martin-mael/sub-eq/viewer/screenshots/07_rayons_x.png

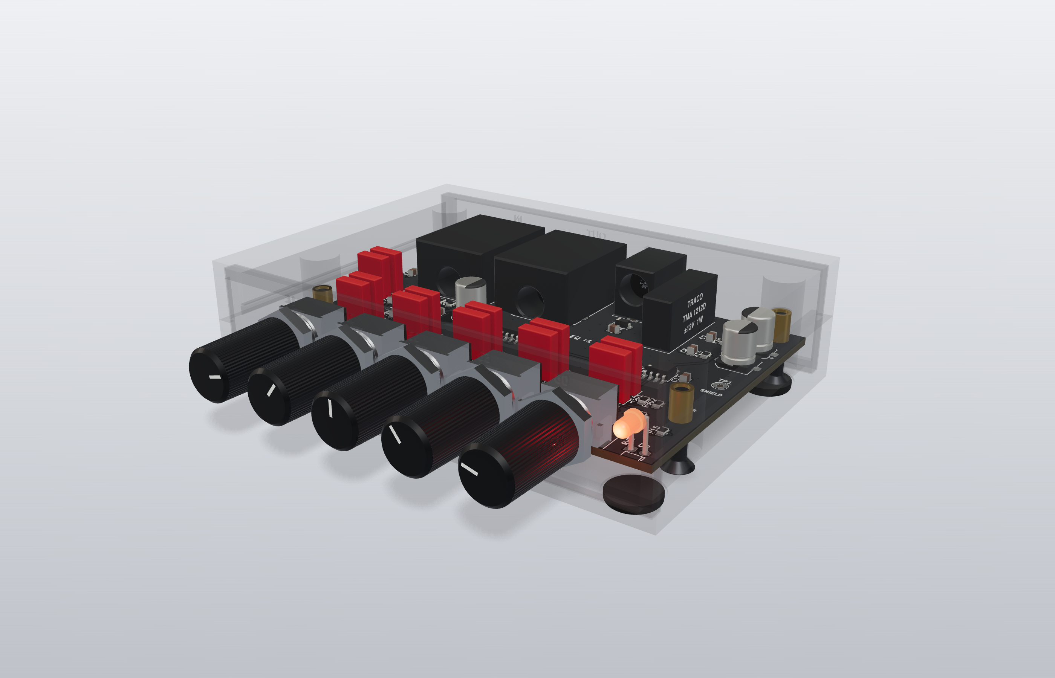
viewer/screenshots/07_rayons_x.png
