martin-mael/sub-eq/viewer/screenshots/01_avant_3-4.png

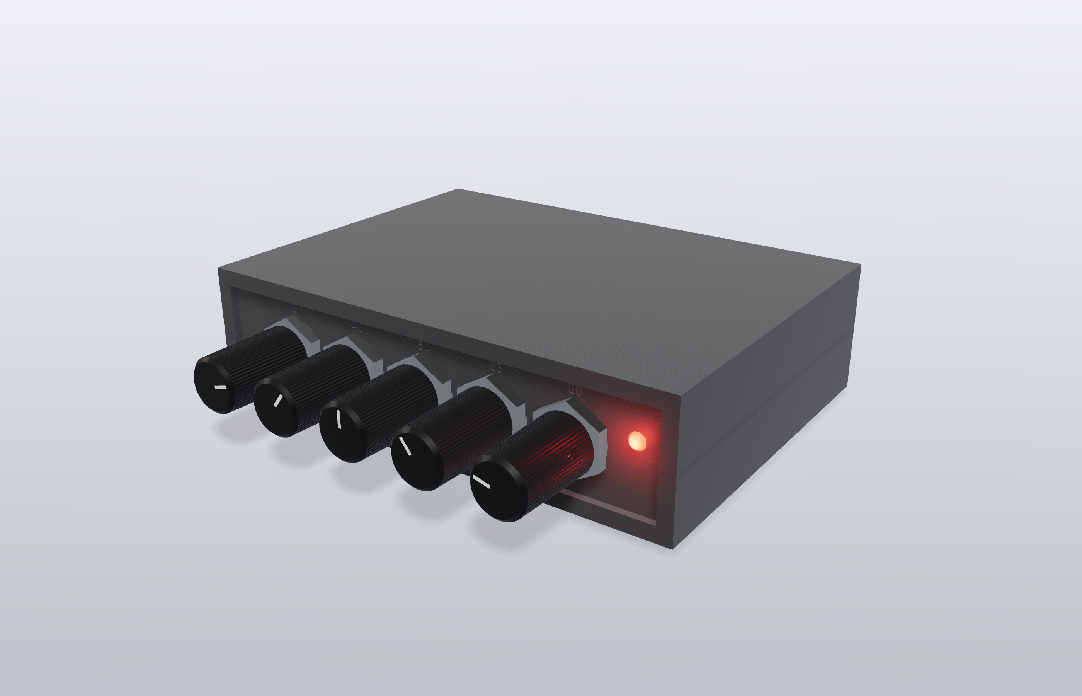
viewer/screenshots/01_avant_3-4.png
