martin-mael/sub-eq/README.md

# Sub EQ

Égaliseur graphique 5 bandes pour caissons de basses (31, 40, 50, 63, 80 Hz), mono, jacks 6,35 mm, alimentation 12 V DC. Exemplaire unique, PCB 90 × 62 mm, boîtier 97 × 71 × 25 mm.

| Document | Contenu |
|---|---|
| [docs/SPEC.md](docs/SPEC.md) | spécification validée et valeurs figées à la conception |
| [docs/sub-eq-fiche.pdf](docs/sub-eq-fiche.pdf) | fiche de présentation : schéma fonctionnel, courbes, carte, nomenclature, coût |
| [docs/BOM.md](docs/BOM.md) | nomenclature détaillée de tous les composants |
| [docs/COMMANDE.md](docs/COMMANDE.md) | PCB, composants, visserie à commander |
| [docs/CHIFFRAGE.md](docs/CHIFFRAGE.md) | coût détaillé |
| [docs/MONTAGE.md](docs/MONTAGE.md) | contrôles, impression, soudure, tests, assemblage |
| [docs/ASSEMBLAGE-JLC.md](docs/ASSEMBLAGE-JLC.md) | option : CMS posés par JLCPCB, devis pour 2, 5 et 10 cartes |

## Fichiers produits

- `hardware/sub-eq.kicad_sch`, `hardware/sub-eq.kicad_pcb` : schéma et carte (générés, ne pas éditer à la main).
- `hardware/fab/` : Gerbers zippés, nomenclatures, PDF du schéma et de l'implantation, STEP de la carte.
- `hardware/sim-report.txt` : réponse calculée à partir des valeurs réelles du circuit.
- `enclosure/out/` : STL et STEP des 4 pièces imprimées, vue éclatée `preview.png`.
- `viewer/` : visionneuse 3D web (voir [viewer/README.md](viewer/README.md)).

| Domaine | Source | Généré |
|---|---|---|
| Visionneuse | `viewer/src/scene/dims.ts`, `Connectors.tsx` | `viewer/public/models/` via `npm run assets` |

Toute modification d'une pièce de panneau se répercute dans `hardware/scripts/gen_pcb.py`, `enclosure/enclosure.py` et `viewer/src/scene/dims.ts`.

## Régénérer

La fiche PDF et `docs/BOM.md` se régénèrent à part, après `build.sh` : `cd hardware/scripts && ../../.venv/bin/python build_doc.py` (il faut Google Chrome et `pypdf`).

```bash
FREEROUTING_JAR=~/.cache/freerouting/freerouting-2.5.0.jar ./build.sh
```

Il faut KiCad 10 dans `~/Applications/KiCad`, Java 21 ou plus, [Freerouting](https://github.com/freerouting/freerouting/releases) 2.5 et un `.venv` avec `numpy`, `build123d` et `cairosvg` (ici un lien vers celui d'audio-box).

Visionneuse 3D : `cd viewer && npm install && npm run assets && npm run dev` (http://localhost:5174).

## Déploiement de la visionneuse sur Vercel

Dans le projet Vercel, le **Root Directory** est `viewer` : Vercel y détecte Vite et lance `npm install`, `npm run build`, puis publie `dist`. `viewer/vercel.json` ne fait que fixer le framework. Les modèles 3D (`viewer/public/models/`) sont versionnés : Vercel n'a besoin ni de KiCad ni de Python. Relance `npm run assets` et commite avant de pousser si le PCB ou le boîtier a changé.
