martin-mael/sub-eq/hardware/sim-report.txt

all pots centred: +0.0000 dB at 50 Hz, +0.0000 dB at 1 kHz

filter cells (design: f0 = 1/(2 pi C sqrt(R3 (R1||R2))), Q = pi f0 C R3, gain = R3/(2 R1)):
  31 Hz: f0 31.5 Hz  Q 4.36  gain 1.000
  40 Hz: f0 40.1 Hz  Q 4.22  gain 1.000
  50 Hz: f0 50.2 Hz  Q 4.30  gain 1.000
  63 Hz: f0 62.9 Hz  Q 4.35  gain 1.000
  80 Hz: f0 80.3 Hz  Q 4.33  gain 1.000

one band at a time (peak frequency, gain, -3 dB Q):
  31 Hz: full boost  31.1 Hz +12.37 dB (Q 2.9) | full cut  31.1 Hz -12.37 dB | pot at 75 %: +3.6 dB
  40 Hz: full boost  39.8 Hz +12.59 dB (Q 3.9) | full cut  39.8 Hz -12.59 dB | pot at 75 %: +3.8 dB
  50 Hz: full boost  50.3 Hz +12.60 dB (Q 4.1) | full cut  50.3 Hz -12.60 dB | pot at 75 %: +3.8 dB
  63 Hz: full boost  63.4 Hz +12.57 dB (Q 3.9) | full cut  63.4 Hz -12.57 dB | pot at 75 %: +3.8 dB
  80 Hz: full boost  81.4 Hz +12.44 dB (Q 2.5) | full cut  81.4 Hz -12.44 dB | pot at 75 %: +3.7 dB

   f     all max  all min  31 max   80 max   +-+-+    with HPF, flat   largest internal node (V per V in, all max)
  10.0   +8.67    -8.67    +3.04    +0.97    +2.13   -12.35           0.96
  16.0  +12.61   -12.61    +5.72    +1.79    +2.98    -5.40           0.89
  20.0  +14.62   -14.62    +7.48    +2.13    +3.52    -3.04           0.81
  25.0  +16.58   -16.58    +9.83    +2.15    +4.52    -1.51           0.65
  31.5  +17.04   -17.04   +12.34    +1.35    +4.94    -0.66           0.43
  35.0  +16.24   -16.24    +9.21    +1.61    -1.19    -0.45           0.48
  40.0  +16.73   -16.73    +4.24    +1.47    -5.66    -0.27           0.42
  45.0  +16.11   -16.11    +3.04    +1.95    +1.07    -0.17           0.46
  50.0  +16.66   -16.66    +1.99    +1.98    +6.06    -0.11           0.42
  56.0  +16.10   -16.10    +1.98    +3.00    +1.20    -0.07           0.46
  63.0  +16.74   -16.74    +1.48    +4.14    -5.71    -0.04           0.42
  71.0  +16.22   -16.22    +1.71    +8.37    -2.30    -0.03           0.48
  80.0  +16.95   -16.95    +1.34   +12.39    +4.97    -0.02           0.44
  90.0  +17.27   -17.27    +1.82   +11.50    +5.57    -0.01           0.52
 100.0  +16.66   -16.66    +2.12   +10.06    +4.75    -0.01           0.64
 125.0  +14.71   -14.71    +2.13    +7.65    +3.67    -0.00           0.80
 160.0  +12.48   -12.48    +1.76    +5.69    +3.05    -0.00           0.89
 250.0   +8.74    -8.74    +0.98    +3.13    +2.22    -0.00           0.96
1000.0   +1.43    -1.43    +0.08    +0.27    +0.34    -0.00           1.00

subsonic HPF: f0 = 20.06 Hz, Q = 0.707
