martin-mael/sub-eq/docs/img/pcb.png

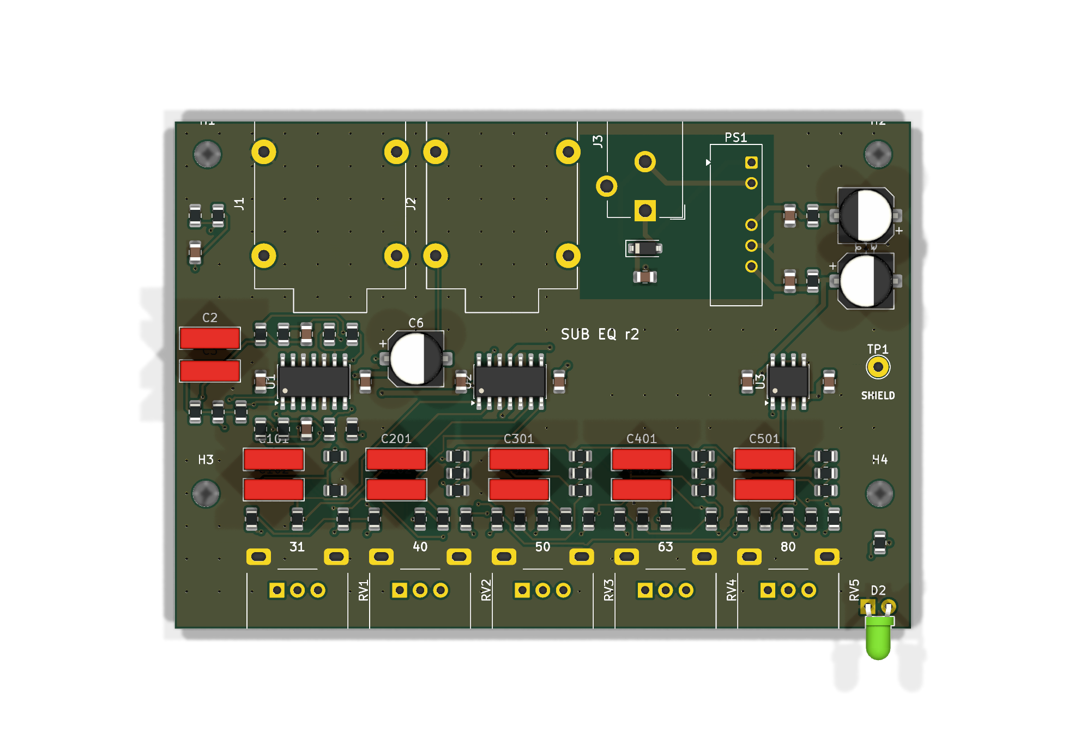
docs/img/pcb.png
