martin-mael/sub-eq/viewer/screenshots/02_arriere_3-4.png

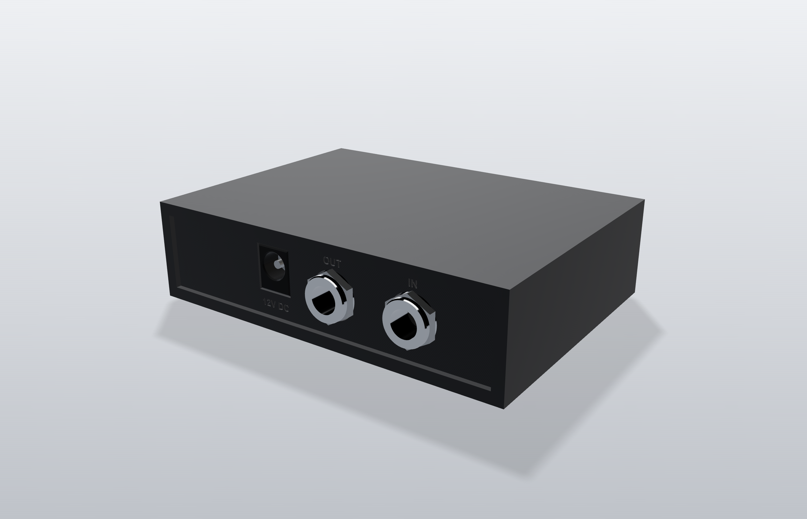
viewer/screenshots/02_arriere_3-4.png
