martin-mael/sub-eq/viewer/screenshots/03_eclate_avant.png

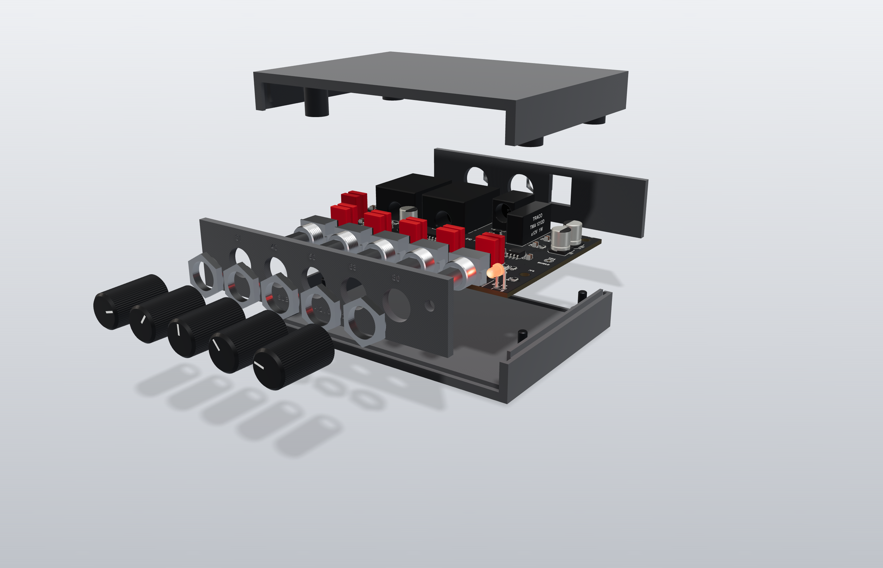
viewer/screenshots/03_eclate_avant.png
