martin-mael/sub-eq/viewer/screenshots/04_eclate_arriere.png

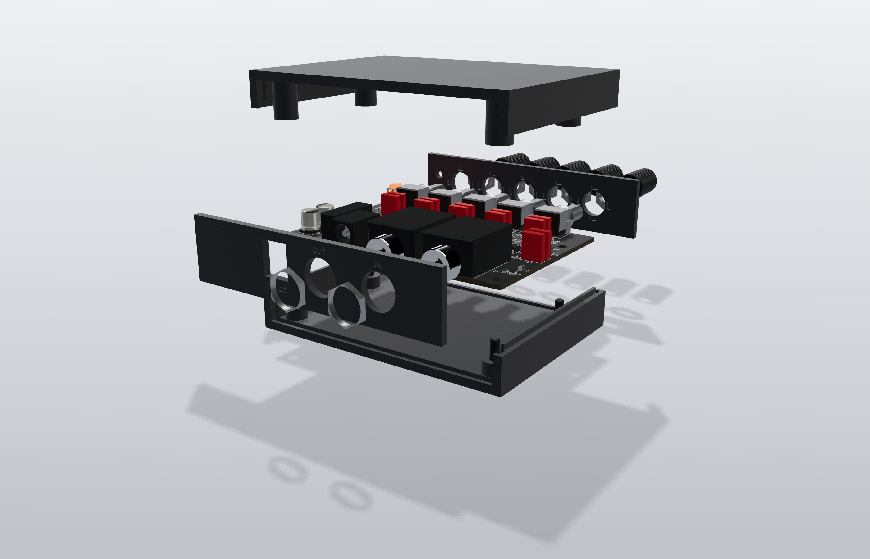
viewer/screenshots/04_eclate_arriere.png
