martin-mael/sub-eq/viewer/screenshots/05_gros_plan_avant.png

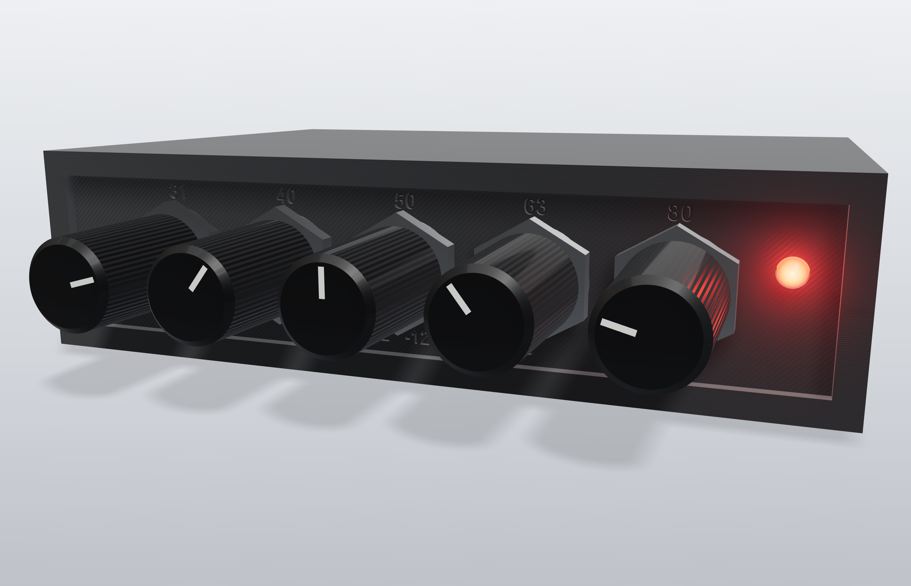
viewer/screenshots/05_gros_plan_avant.png
