martin-mael/sub-eq/hardware/fab/bom_mouser_smd.csv

Manufacturer | Manufacturer Part Number | Quantity | Designators | Qty on board | Description
Yageo | CC0805JRNPO9BN102 | 10 | C1 | 1 | Cap 1nF 50V 0805 (C0G here; X7R is fine too)
Nichicon | UWT1V101MCL1GS | 4 | C10 C11 C6 | 3 | Alu electrolytic 100uF 35V 6.3x7.7
Yageo | CC0805KRX7R9BB104 | 20 | C12 C13 C14 C15 C16 C17 | 6 | Cap 100nF 50V X7R 0805
Samsung | CL21C220JBANNNC | 10 | C4 C5 | 2 | Cap 22pF 50V C0G 0805
Samsung | CL21A106KAYNNNG | 10 | C7 C8 C9 | 3 | Cap 10uF 25V X5R 0805
Diodes Inc. | 1N5819HW-7-F | 2 | D1 | 1 | Schottky 40 V 1 A SOD-123 (reverse-polarity protection)
Yageo | RC0805FR-071ML | 10 | R1 | 1 | Resistor 1M 1% 0805
Yageo | RC0805FR-0720KL | 10 | R10 R5 R6 R7 R8 R9 | 6 | Resistor 20k 1% 0805
Yageo | RC0805FR-07100KL | 10 | R101 R12 R303 R403 | 4 | Resistor 100k 1% 0805
Yageo | RC0805FR-072K7L | 10 | R102 | 1 | Resistor 2.7k 1% 0805
Yageo | RC0805FR-07200KL | 10 | R103 | 1 | Resistor 200k 1% 0805
Yageo | RC0805FR-072KL | 10 | R104 R105 R204 R205 R304 R305 R404 R405 R504 R505 | 10 | Resistor 2k 1% 0805
Yageo | RC0805FR-07100RL | 10 | R11 | 1 | Resistor 100 1% 0805
Yageo | RC0805FR-0710RL | 10 | R13 R14 | 2 | Resistor 10 1% 0805
Yageo | RC0805FR-074K7L | 10 | R15 | 1 | Resistor 4.7k 1% 0805
Yageo | RC0805FR-0751KL | 10 | R16 R3 R4 | 3 | Resistor 51k 1% 0805
Yageo | RC0805FR-07470RL | 10 | R2 | 1 | Resistor 470 1% 0805
Yageo | RC0805FR-0768KL | 10 | R201 R503 | 2 | Resistor 68k 1% 0805
Yageo | RC0805FR-072K2L | 10 | R202 | 1 | Resistor 2.2k 1% 0805
Yageo | RC0805FR-07150KL | 10 | R203 | 1 | Resistor 150k 1% 0805
Yageo | RC0805FR-078K2L | 10 | R206 | 1 | Resistor 8.2k 1% 0805
Yageo | RC0805FR-072K4L | 10 | R208 | 1 | Resistor 2.4k 1% 0805
Yageo | RC0805FR-0747KL | 10 | R301 R401 | 2 | Resistor 47k 1% 0805
Yageo | RC0805FR-071K5L | 10 | R302 | 1 | Resistor 1.5k 1% 0805
Yageo | RC0805FR-0715KL | 10 | R306 | 1 | Resistor 15k 1% 0805
Panasonic | ERJ-6ENF2200V | 10 | R307 | 1 | Resistor 220 1% 0805 (Yageo out of stock)
Yageo | RC0805FR-0724KL | 10 | R308 | 1 | Resistor 24k 1% 0805
Yageo | RC0805FR-07680RL | 10 | R402 R407 R502 | 3 | Resistor 680 1% 0805
Yageo | RC0805FR-073KL | 10 | R406 | 1 | Resistor 3k 1% 0805
Yageo | RC0805FR-0727KL | 10 | R501 | 1 | Resistor 27k 1% 0805
Yageo | RC0805FR-0712KL | 10 | R506 | 1 | Resistor 12k 1% 0805
Yageo | RC0805FR-07390RL | 10 | R507 | 1 | Resistor 390 1% 0805
Yageo | RC0805FR-0710KL | 10 | R508 | 1 | Resistor 10k 1% 0805
Texas Instruments | TL074CDR | 2 | U1 U2 | 2 | Quad JFET op-amp SOIC-14
Texas Instruments | TL072CDR | 1 | U3 | 1 | Dual JFET op-amp SOIC-8
