martin-mael/sub-eq/hardware/jlc/bom_jlc.csv

Comment | Designator | Footprint | JLCPCB Part #
1n | C1 | C_0805_2012Metric | C46653
22p C0G | C4,C5 | C_0805_2012Metric | C1804
100u 35V | C6,C10,C11 | CP_Elec_6.3x7.7 | C970686
10u 25V | C7,C8,C9 | C_0805_2012Metric | C15850
100n | C12,C13,C14,C15,C16,C17 | C_0805_2012Metric | C49678
1N5819HW | D1 | D_SOD-123 | C8598
1M | R1 | R_0805_2012Metric | C17514
470 | R2 | R_0805_2012Metric | C17710
51k | R3,R4,R16 | R_0805_2012Metric | C17737
20k | R5,R6,R7,R8,R9,R10 | R_0805_2012Metric | C4328
100 | R11 | R_0805_2012Metric | C17408
100k | R12,R101,R303,R403 | R_0805_2012Metric | C149504
10 | R13,R14 | R_0805_2012Metric | C17415
4.7k | R15 | R_0805_2012Metric | C17673
2.7k | R102 | R_0805_2012Metric | C17530
200k | R103 | R_0805_2012Metric | C17539
2k | R104,R105,R204,R205,R304,R305,R404,R405,R504,R505 | R_0805_2012Metric | C17604
68k | R201,R503 | R_0805_2012Metric | C17801
2.2k | R202 | R_0805_2012Metric | C17520
150k | R203 | R_0805_2012Metric | C17470
8.2k | R206 | R_0805_2012Metric | C17828
2.4k | R208 | R_0805_2012Metric | C17526
47k | R301,R401 | R_0805_2012Metric | C17713
1.5k | R302 | R_0805_2012Metric | C4310
15k | R306 | R_0805_2012Metric | C17475
220 | R307 | R_0805_2012Metric | C17557
24k | R308 | R_0805_2012Metric | C17575
680 | R402,R407,R502 | R_0805_2012Metric | C17798
3k | R406 | R_0805_2012Metric | C17661
27k | R501 | R_0805_2012Metric | C17593
12k | R506 | R_0805_2012Metric | C17444
390 | R507 | R_0805_2012Metric | C17655
10k | R508 | R_0805_2012Metric | C17414
TL074 | U1,U2 | SOIC-14_3.9x8.7mm_P1.27mm | C12594
TL072 | U3 | SOIC-8_3.9x4.9mm_P1.27mm | C6961
