martin-mael/sub-eq/enclosure/out/assembly.step

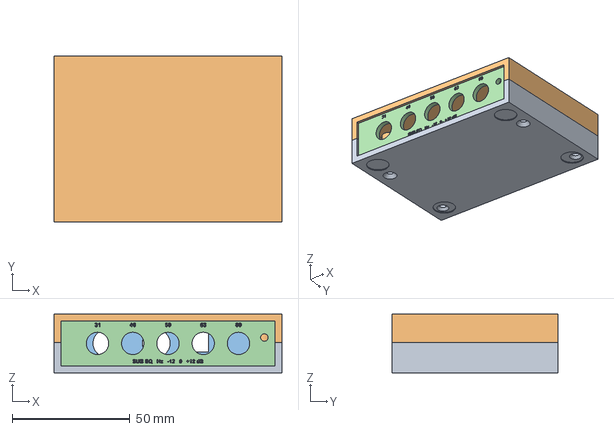
[picture p15: CAD file, 2026-11-11]
enclosure/out/assembly.step
97.0 x 70.6 x 25.1 mm
