martin-mael/sub-eq/enclosure/out/lid.step

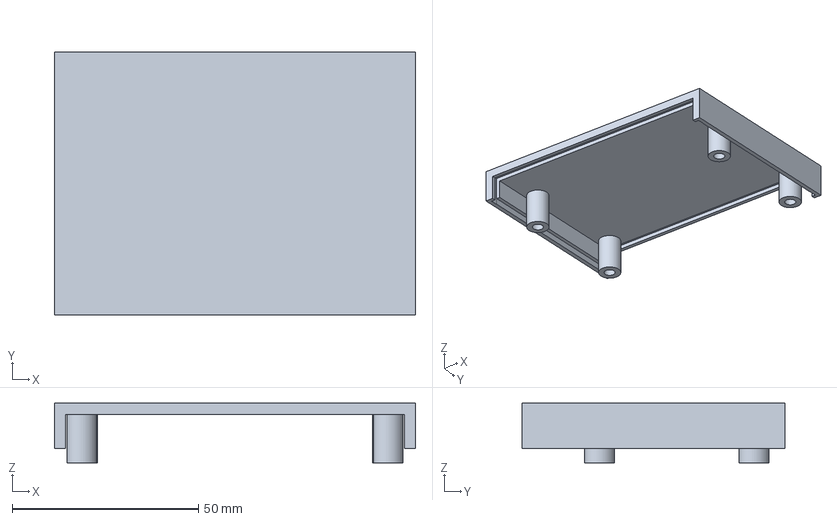
[picture p16: CAD file, 2026-11-11]
enclosure/out/lid.step
97.0 x 70.6 x 16.0 mm
