martin-mael/sub-eq/hardware/fab/sub-eq-pcb.step

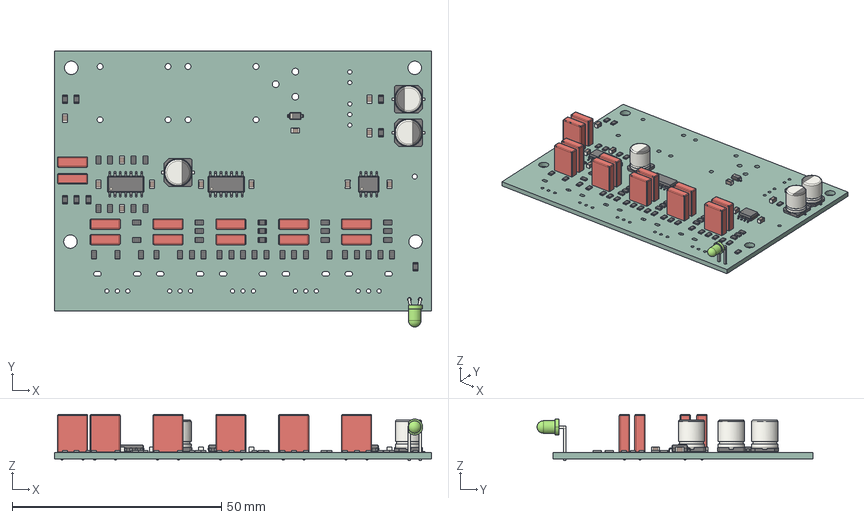
[picture p17: CAD file, 2026-11-11]
hardware/fab/sub-eq-pcb.step
90.0 x 65.9 x 11.0 mm
R_0805_2012Metric x 51
SOIC-8_3.9x4.9mm_P1.27mm
C_0805_2012Metric x 12
C_Rect_L72mm_W25mm_P500mm_FKS2_FKP2_MKS2_MKP2 x 12
SOIC-14_3.9x8.7mm_P1.27mm x 2
CP_Elec_63x77 x 3
D_SOD-123
LED_D3.0mm_Horizontal_O1.27mm_Z6.0mm
sub-eq_PCB
