martin-mael/sub-eq/enclosure/out/back_panel.step

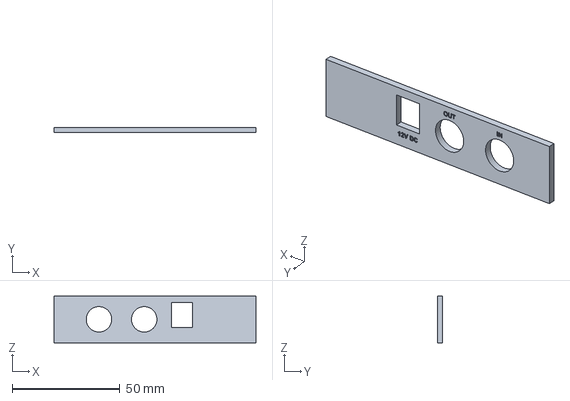
[picture p18: CAD file, 2026-11-11]
enclosure/out/back_panel.step
93.7 x 2.50 x 21.8 mm
