martin-mael/sub-eq/enclosure/out/tray.step

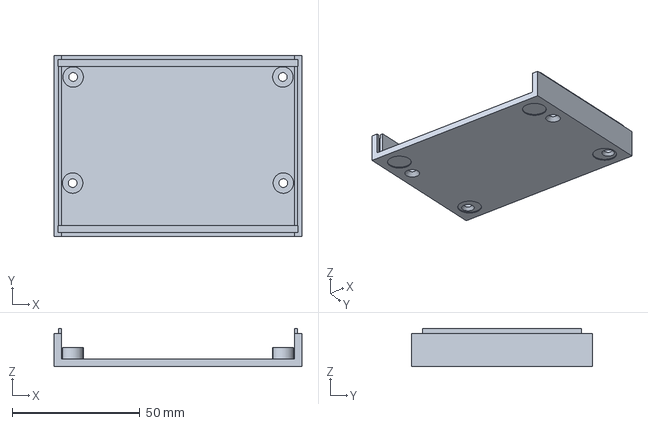
[picture p19: CAD file, 2026-11-11]
enclosure/out/tray.step
97.0 x 70.6 x 15.0 mm
