martin-mael/sub-eq/enclosure/out/front_panel.step

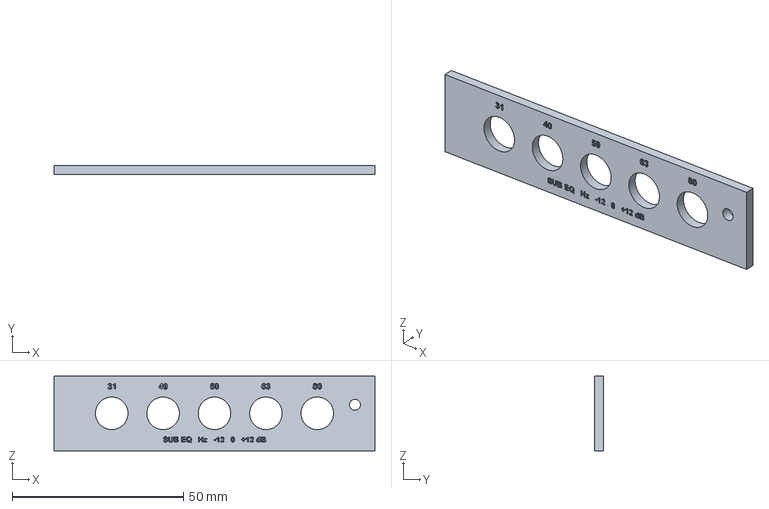
[picture p20: CAD file, 2026-11-11]
enclosure/out/front_panel.step
93.7 x 2.50 x 21.8 mm
