martin-mael/sub-eq/(list of files, cad)

Other CAD files:
enclosure/out/back_panel.stl
enclosure/out/front_panel.stl
enclosure/out/lid.stl
enclosure/out/tray.stl
