martin-mael/sub-eq/hardware/fab/pcb-top.pdf

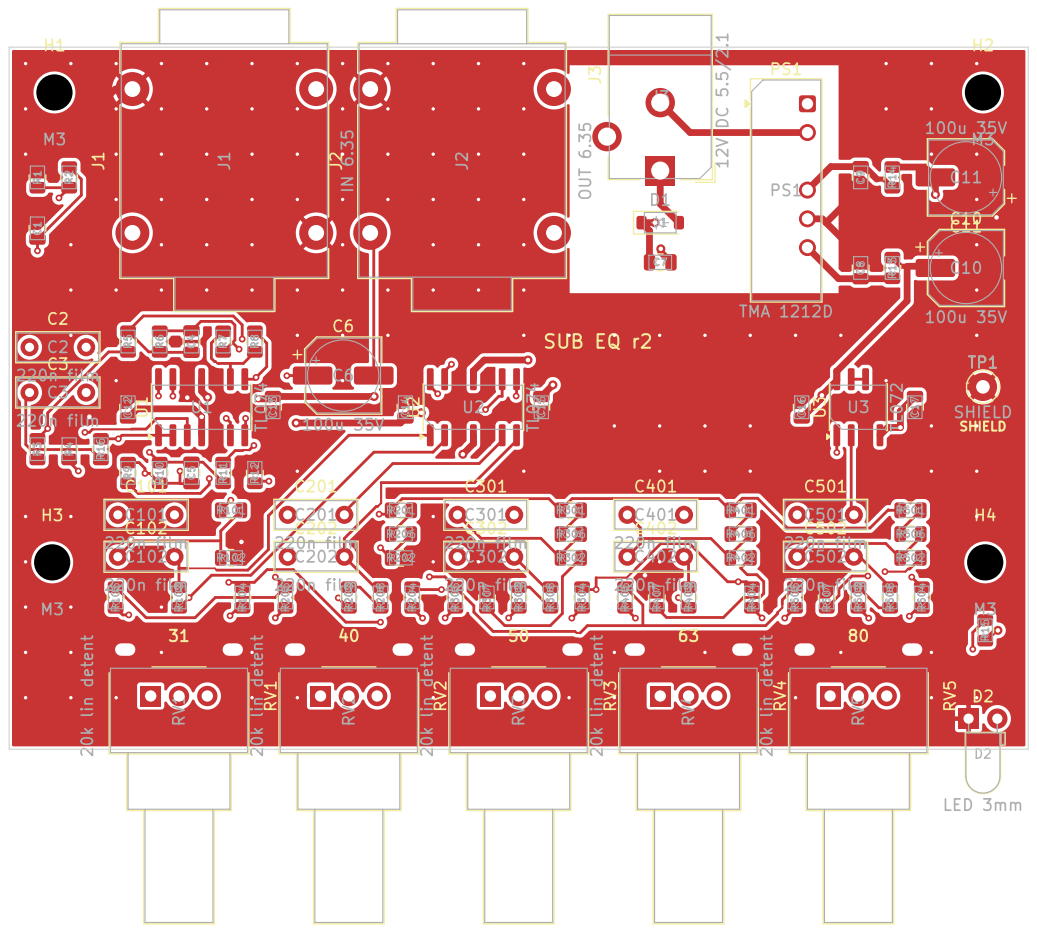
[picture p21: page 1]
