martin-mael/sub-eq/hardware/sub-eq.kicad_pcb

## KiCad design hardware/sub-eq.kicad_pcb (2026-11-11)

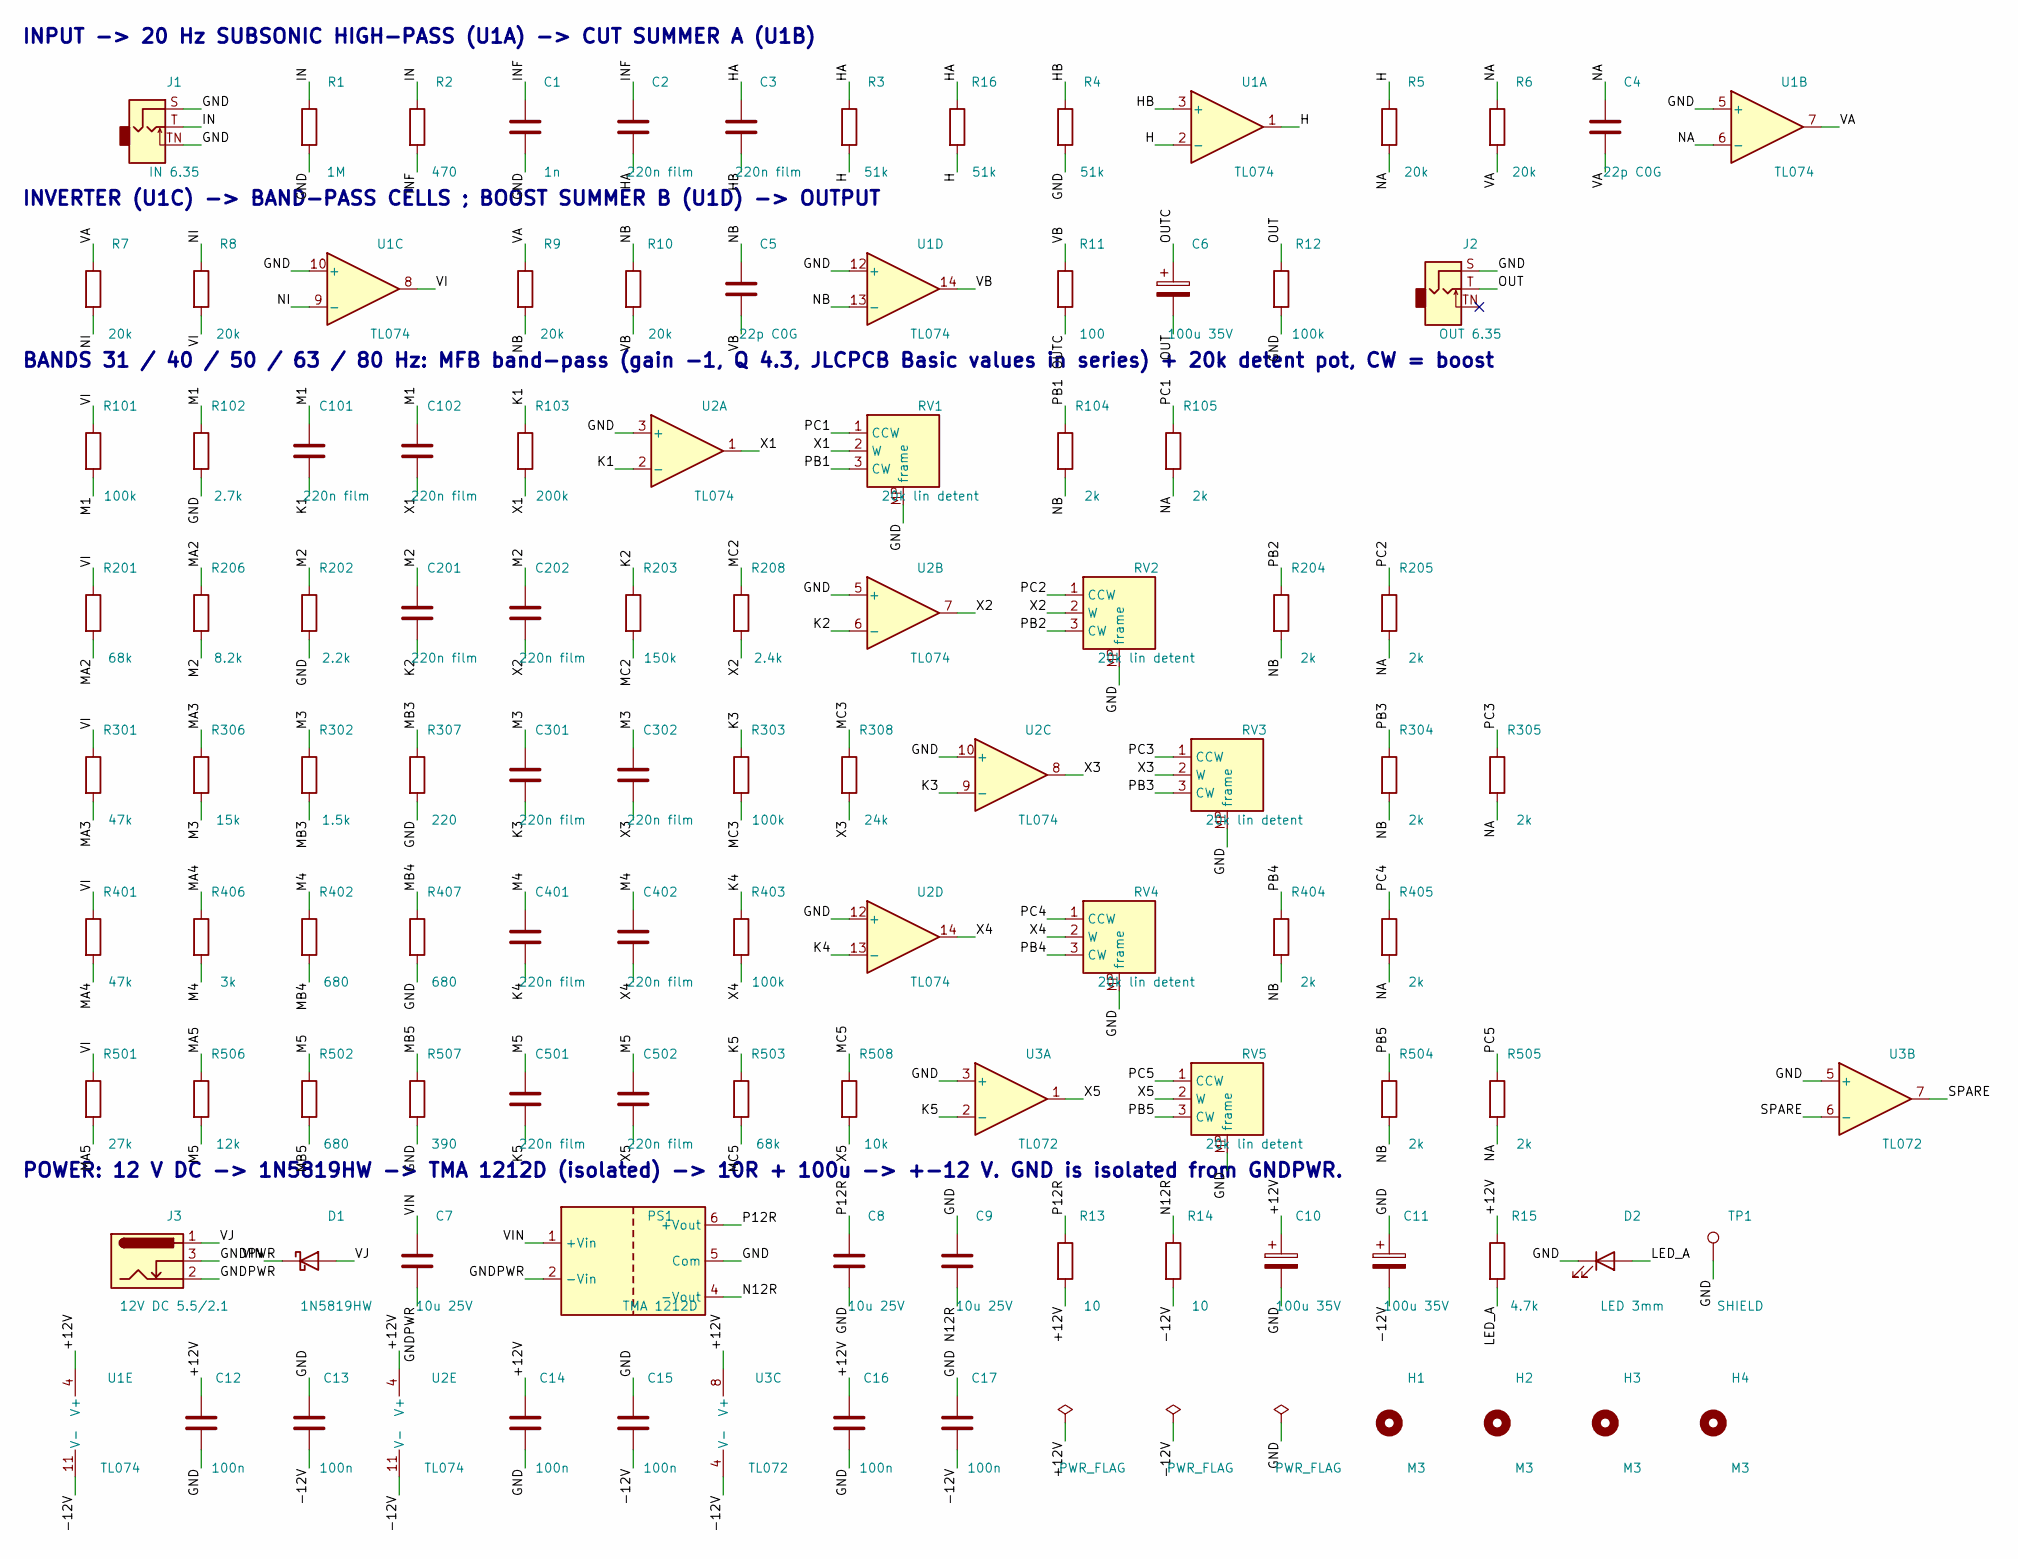
[picture p22: schematic sub-eq.kicad_sch, Sub EQ - 5-band graphic EQ for subwoofers (31 / 40 / 50 / 6…]

Parts:
C1: 1n; C_0805_2012Metric
C2, C3, C101, C102, C201, C202, C301, C302, C401, C402, C501, C502: 220n film; C_Rect_L7.2mm_W2.5mm_P5.00mm_FKS2_FKP2_MKS2_MKP2
C4, C5: 22p C0G; C_0805_2012Metric
C6, C10, C11: 100u 35V; CP_Elec_6.3x7.7
C7, C8, C9: 10u 25V; C_0805_2012Metric
C12, C13, C14, C15, C16, C17: 100n; C_0805_2012Metric
D1: 1N5819HW; D_SOD-123
D2: LED 3mm; LED_D3.0mm_Horizontal_O1.27mm_Z6.0mm
H1, H2, H3, H4: M3; MountingHole_3.2mm_M3
J1: IN 6.35; Jack_6.35mm_Neutrik_NMJ4HCD2_Horizontal
J2: OUT 6.35; Jack_6.35mm_Neutrik_NMJ4HCD2_Horizontal
J3: 12V DC 5.5/2.1; BarrelJack_CUI_PJ-102AH_Horizontal
PS1: TMA 1212D; Converter_DCDC_TRACO_TMA-05xxD_12xxD_Dual_THT
R1: 1M; R_0805_2012Metric
R2: 470; R_0805_2012Metric
R3, R4, R16: 51k; R_0805_2012Metric
R5, R6, R7, R8, R9, R10: 20k; R_0805_2012Metric
R11: 100; R_0805_2012Metric
R12, R101, R303, R403: 100k; R_0805_2012Metric
R13, R14: 10; R_0805_2012Metric
R15: 4.7k; R_0805_2012Metric
R102: 2.7k; R_0805_2012Metric
R103: 200k; R_0805_2012Metric
R104, R105, R204, R205, R304, R305, R404, R405, R504, R505: 2k; R_0805_2012Metric
R201, R503: 68k; R_0805_2012Metric
R202: 2.2k; R_0805_2012Metric
R203: 150k; R_0805_2012Metric
R206: 8.2k; R_0805_2012Metric
R208: 2.4k; R_0805_2012Metric
R301, R401: 47k; R_0805_2012Metric
R302: 1.5k; R_0805_2012Metric
R306: 15k; R_0805_2012Metric
R307: 220; R_0805_2012Metric
R308: 24k; R_0805_2012Metric
R402, R407, R502: 680; R_0805_2012Metric
R406: 3k; R_0805_2012Metric
R501: 27k; R_0805_2012Metric
R506: 12k; R_0805_2012Metric
R507: 390; R_0805_2012Metric
R508: 10k; R_0805_2012Metric
RV1, RV2, RV3, RV4, RV5: 20k lin detent; Potentiometer_Alps_RK09L_Single_Horizontal
TP1: SHIELD; TestPoint_THTPad_D2.5mm_Drill1.2mm
U1, U2: TL074; SOIC-14_3.9x8.7mm_P1.27mm
U3: TL072; SOIC-8_3.9x4.9mm_P1.27mm

Connections:
/+12V: C10.1, C12.1, C14.1, C16.1, R13.2, R15.1, U1.4 (V+), U2.4 (V+), U3.8 (V+)
/-12V: C11.2, C13.2, C15.2, C17.2, R14.2, U1.11 (V-), U2.11 (V-), U3.4 (V-)
/GND: C1.2, C8.2, C9.1, C10.2, C11.1, C12.2, C13.1, C14.2, C15.1, C16.2, C17.1, D2.1 (K), J1.S, J1.TN, J2.S, PS1.5 (Com), R1.2, R4.2, R12.2, R102.2, R202.2, R307.2, R407.2, R507.2, RV1.MP (frame), RV2.MP (frame), RV3.MP (frame), RV4.MP (frame), RV5.MP (frame), TP1.1, U1.5 (+), U1.10 (+), U1.12 (+), U2.3 (+), U2.5 (+), U2.10 (+), U2.12 (+), U3.3 (+), U3.5 (+)
/GNDPWR: C7.2, J3.2, J3.3, PS1.2 (-Vin)
/H: R3.2, R5.1, R16.2, U1.1, U1.2 (-)
/HA: C2.2, C3.1, R3.1, R16.1
/HB: C3.2, R4.1, U1.3 (+)
/IN: J1.T, R1.1, R2.1
/INF: C1.1, C2.1, R2.2
/K1: C101.2, R103.1, U2.2 (-)
/K2: C201.2, R203.1, U2.6 (-)
/K3: C301.2, R303.1, U2.9 (-)
/K4: C401.2, R403.1, U2.13 (-)
/K5: C501.2, R503.1, U3.2 (-)
/LED_A: D2.2 (A), R15.2
/M1: C101.1, C102.1, R101.2, R102.1
/M2: C201.1, C202.1, R202.1, R206.2
/M3: C301.1, C302.1, R302.1, R306.2
/M4: C401.1, C402.1, R402.1, R406.2
/M5: C501.1, C502.1, R502.1, R506.2
/MA2: R201.2, R206.1
/MA3: R301.2, R306.1
/MA4: R401.2, R406.1
/MA5: R501.2, R506.1
/MB3: R302.2, R307.1
/MB4: R402.2, R407.1
/MB5: R502.2, R507.1
/MC2: R203.2, R208.1
/MC3: R303.2, R308.1
/MC5: R503.2, R508.1
/N12R: C9.2, PS1.4 (-Vout), R14.1
/NA: C4.1, R5.2, R6.1, R105.2, R205.2, R305.2, R405.2, R505.2, U1.6 (-)
/NB: C5.1, R9.2, R10.1, R104.2, R204.2, R304.2, R404.2, R504.2, U1.13 (-)
/NI: R7.2, R8.1, U1.9 (-)
/OUT: C6.2, J2.T, R12.1
/OUTC: C6.1, R11.2
/P12R: C8.1, PS1.6 (+Vout), R13.1
/PB1: R104.1, RV1.3 (CW)
/PB2: R204.1, RV2.3 (CW)
/PB3: R304.1, RV3.3 (CW)
/PB4: R404.1, RV4.3 (CW)
/PB5: R504.1, RV5.3 (CW)
/PC1: R105.1, RV1.1 (CCW)
/PC2: R205.1, RV2.1 (CCW)
/PC3: R305.1, RV3.1 (CCW)
/PC4: R405.1, RV4.1 (CCW)
/PC5: R505.1, RV5.1 (CCW)
/SPARE: U3.6 (-), U3.7
/VA: C4.2, R6.2, R7.1, R9.1, U1.7
/VB: C5.2, R10.2, R11.1, U1.14
/VI: R8.2, R101.1, R201.1, R301.1, R401.1, R501.1, U1.8
/VIN: C7.1, D1.1 (K), PS1.1 (+Vin)
/VJ: D1.2 (A), J3.1
/X1: C102.2, R103.2, RV1.2 (W), U2.1
/X2: C202.2, R208.2, RV2.2 (W), U2.7
/X3: C302.2, R308.2, RV3.2 (W), U2.8
/X4: C402.2, R403.2, RV4.2 (W), U2.14
/X5: C502.2, R508.2, RV5.2 (W), U3.1

Notes on the sheet:
INPUT -> 20 Hz SUBSONIC HIGH-PASS (U1A) -> CUT SUMMER A (U1B)
INVERTER (U1C) -> BAND-PASS CELLS ; BOOST SUMMER B (U1D) -> OUTPUT
BANDS 31 / 40 / 50 / 63 / 80 Hz: MFB band-pass (gain -1, Q 4.3, JLCPCB Basic values in series) + 20k detent pot, CW = boost
POWER: 12 V DC -> 1N5819HW -> TMA 1212D (isolated) -> 10R + 100u -> +-12 V. GND is isolated from GNDPWR.

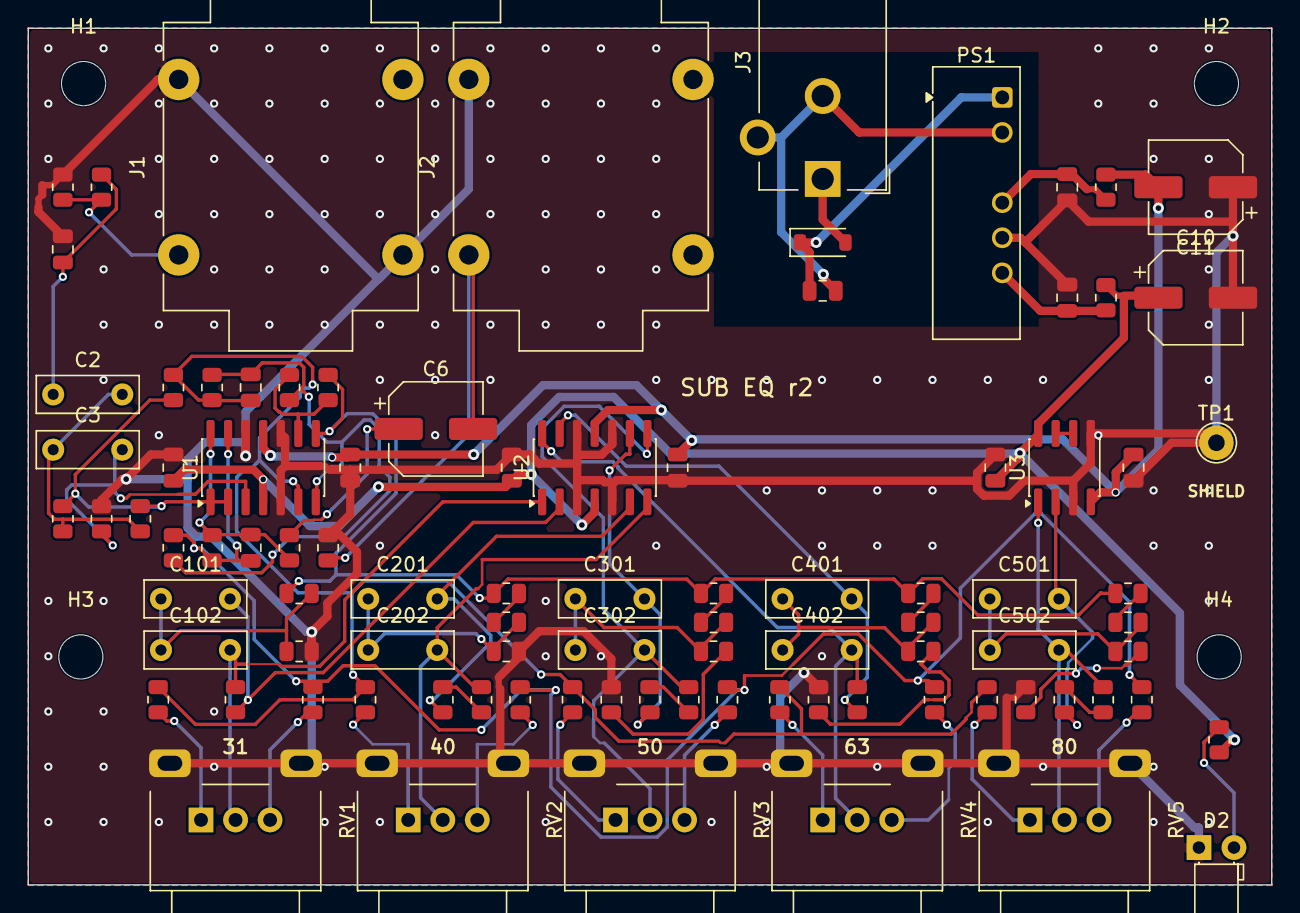
[picture p23: board sub-eq.kicad_pcb from above]

Board: 2 copper layers, 90.0 x 62.0 mm, 97 parts (0 on the bottom side), 58 nets.
