martin-mael/sub-eq/(commit log)

2026-11-10 Sub EQ: 5-band graphic EQ for subwoofers
    Scripted KiCad schematic and PCB (ERC 0, DRC 0), response simulation,
    3D-printed enclosure (0 interference), fabrication files, BOM, docs
    and 3D viewer.
    [assembly.step, back_panel.step, back_panel.stl, bom_hand_solder.csv, bom_mouser_smd.csv, front_panel.step, front_panel.stl, lid.step]
2026-11-10 Rework bands on JLCPCB basic parts, add assembly files and project sheet
    - Band resistors recomputed with basic-catalogue values (some in series):
    extended parts drop from 19 to 2, response unchanged within 1 %
    - hardware/jlc: BOM with LCSC references and placement file (build_jlc.py)
    - docs: project sheet PDF, detailed BOM, JLCPCB assembly quotes, ordering and
    costing for 2 units with assembled SMD parts (build_doc.py)
    - Schematic, PCB, fabrication files, enclosure check and viewer assets regenerated
    [assembly.step, back_panel.step, bom_jlc.csv, bom_mouser_smd.csv, front_panel.step, lid.step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]
2026-11-11 Rev 2: apply PCBA review findings
    - JLCPCB placement file: usual rotation offsets (SOIC, electrolytics)
    - Keep the audio ground pour 2 mm away from the adapter-side nets
    - Small SMD references moved from silkscreen to the assembly drawing
    - Revision on schematic and board, fabrication manifest with hashes,
    no drill maps in the Gerber zip
    - Routing script now stops when board generation fails
    - Fit check also compares part envelopes with modelled parts
    - Docs: first power-up under current limit, isolation check, placement
    preview checklist, maximum level corrected to about +17 dBu
    - Project sheet: realistic EQ settings chart
    [assembly.step, back_panel.step, front_panel.step, lid.step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]
